Govish/Foxglove-DSP-Amplifier-Hardware/Renderings/Amplifier Rendering 2.PNG

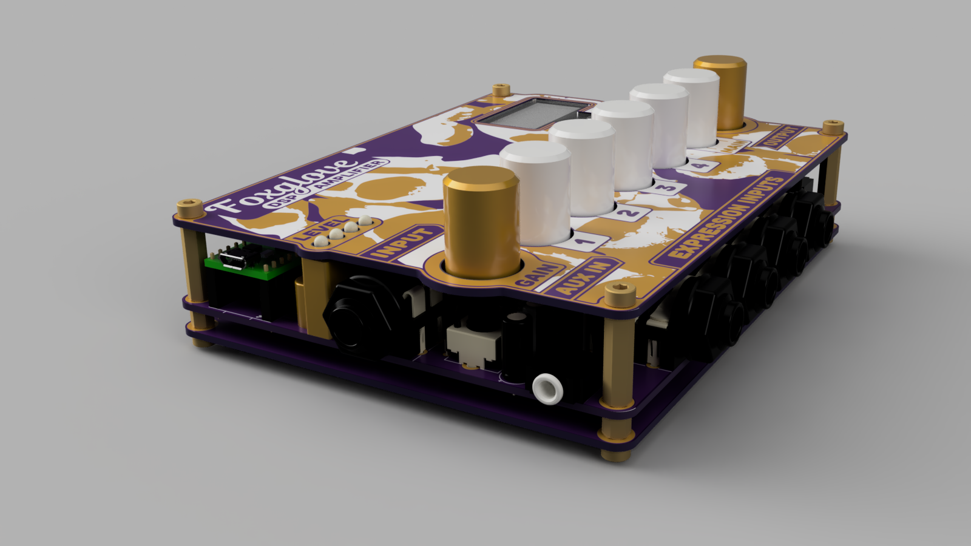
Renderings/Amplifier Rendering 2.PNG
