Govish/Foxglove-DSP-Amplifier-Hardware/Renderings/Amplifier Rendering 4.PNG

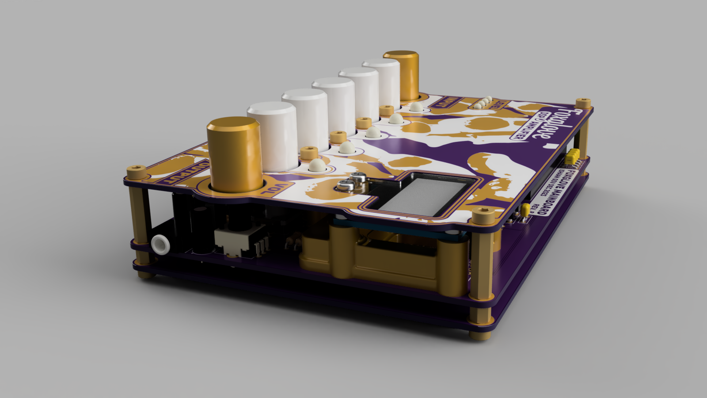
Renderings/Amplifier Rendering 4.PNG
