Govish/Foxglove-DSP-Amplifier-Hardware/README.md

# Foxglove DSP Amplifier
 Design data for a DSP-based guitar effects processor
