Govish/Foxglove-DSP-Amplifier-Hardware/Amplifier ECAD/graphics/Mainboard Label.png

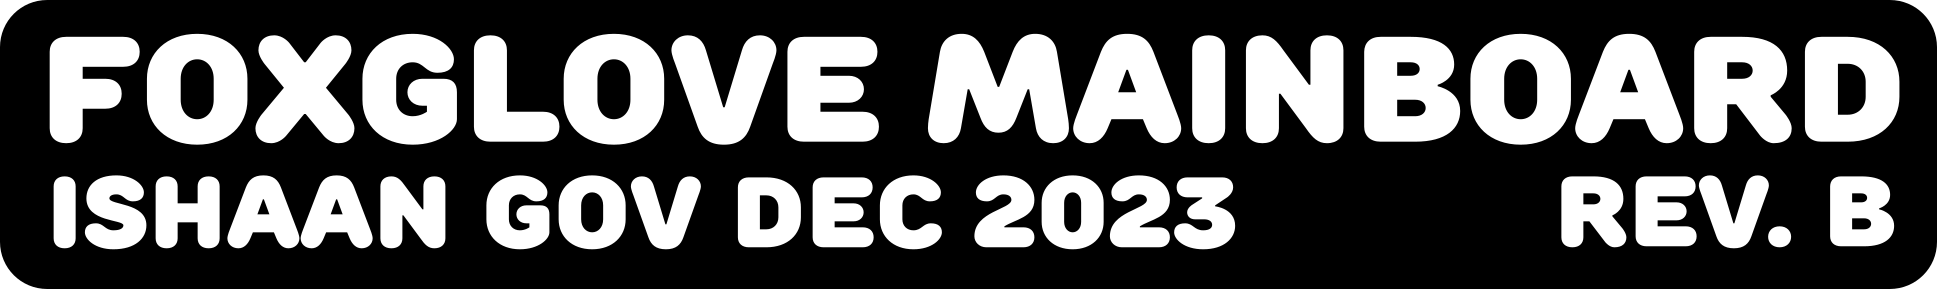
Amplifier ECAD/graphics/Mainboard Label.png
