Govish/Foxglove-DSP-Amplifier-Hardware/Renderings/Amplifier Rendering 1.PNG

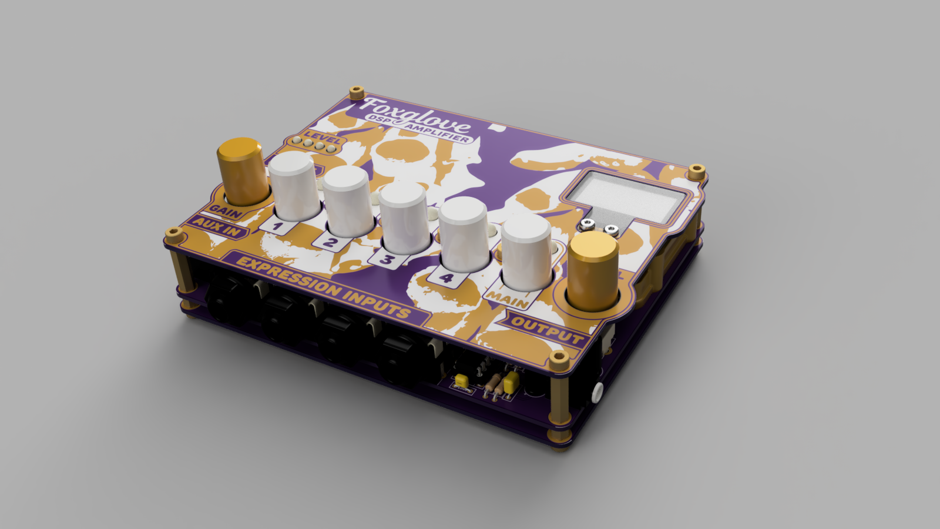
Renderings/Amplifier Rendering 1.PNG
