Govish/Foxglove-DSP-Amplifier-Hardware/Renderings/Amplifier Rendering 3.PNG

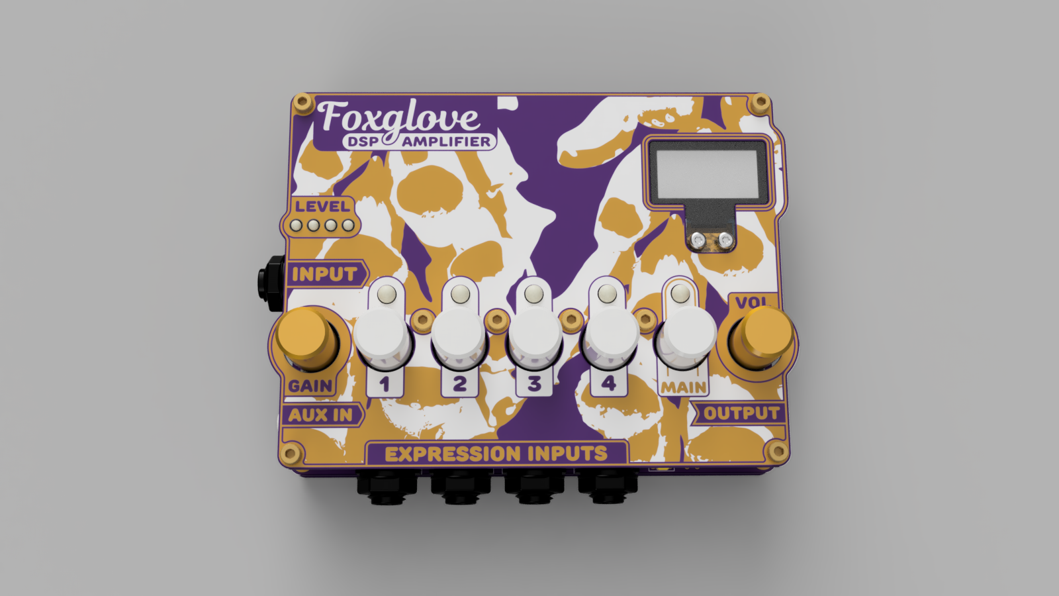
Renderings/Amplifier Rendering 3.PNG
