Govish/Foxglove-DSP-Amplifier-Hardware/Renderings/Amplifier Rendering 5.PNG

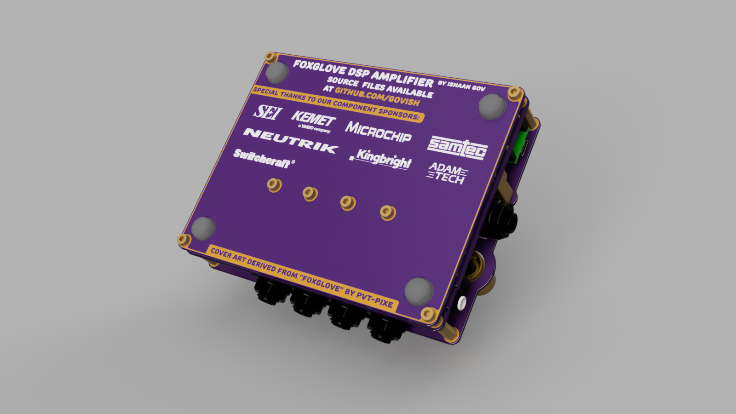
Renderings/Amplifier Rendering 5.PNG
