Govish/Foxglove-DSP-Amplifier-Hardware/Amplifier Rear Panel/Amplifier Rear Panel/Amplifier Rear Panel.step

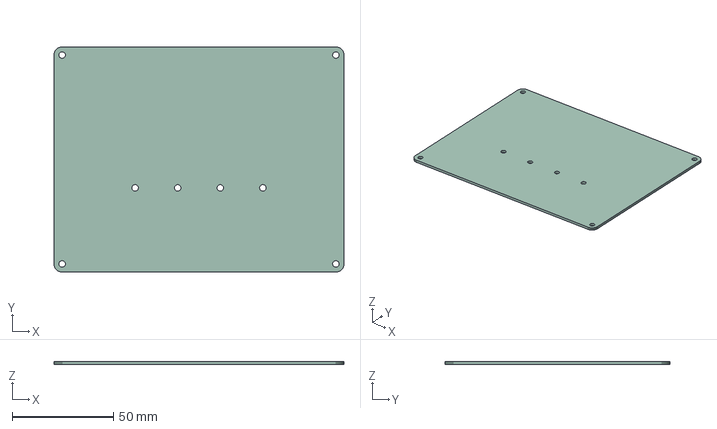
[picture p7: CAD file, 2024-01-23]
Amplifier Rear Panel/Amplifier Rear Panel/Amplifier Rear Panel.step
143.0 x 111.0 x 1.58 mm
