Govish/Foxglove-DSP-Amplifier-Hardware/Amplifier ECAD/Amplifier Hardware RevB.pdf

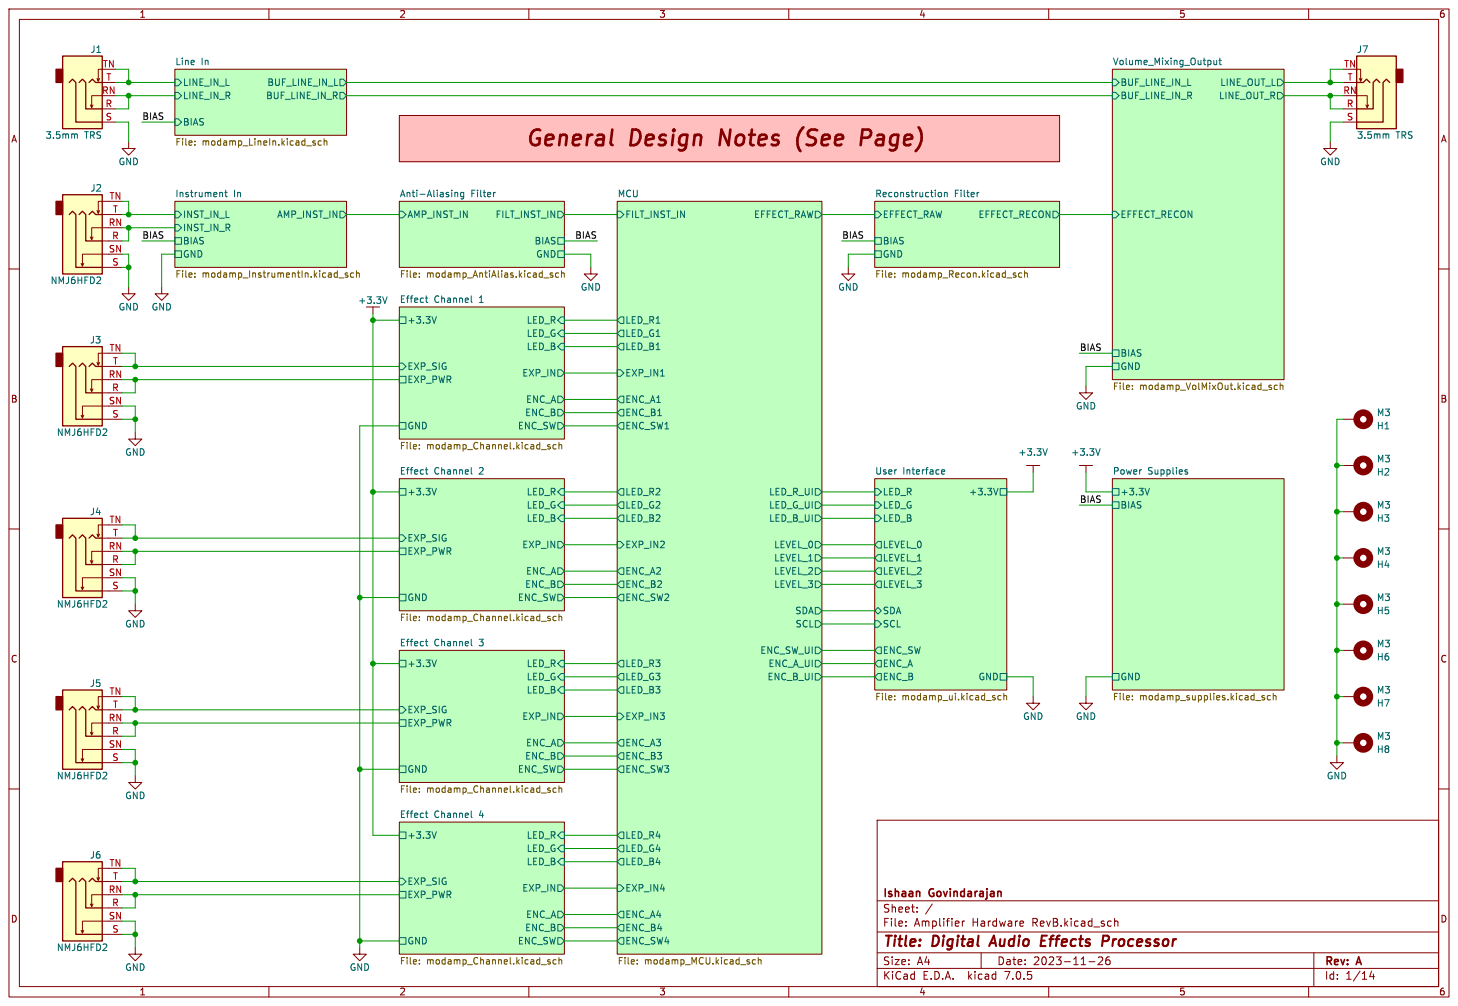
[picture p8: page 1]

INST_IN_R GND
Effect Channel 2 File: modamp_Channel.kicad_sch BIAS

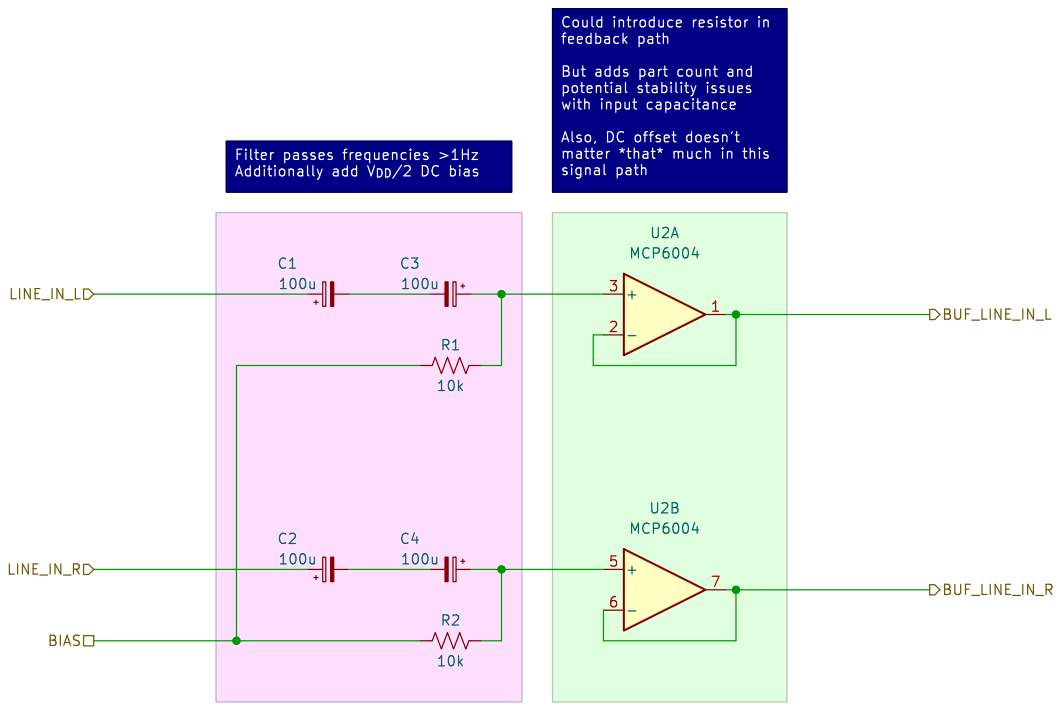
[picture p9: page 2]

feedback path But adds part count and

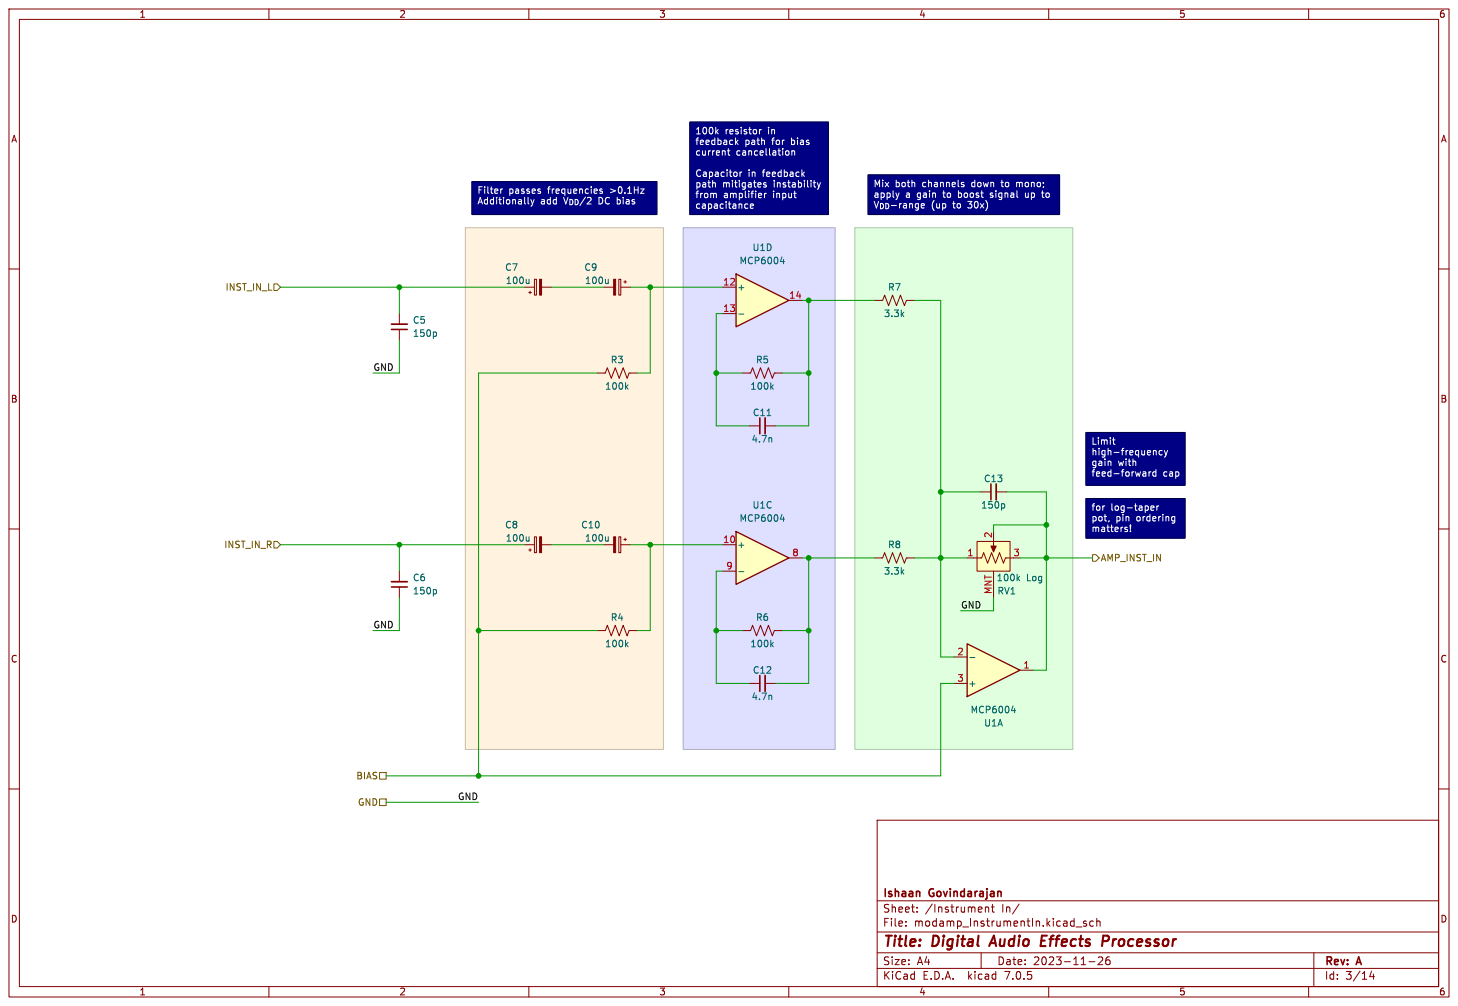
[picture p10: page 3]

for log-taper pot, pin ordering matters! Limit high-frequency

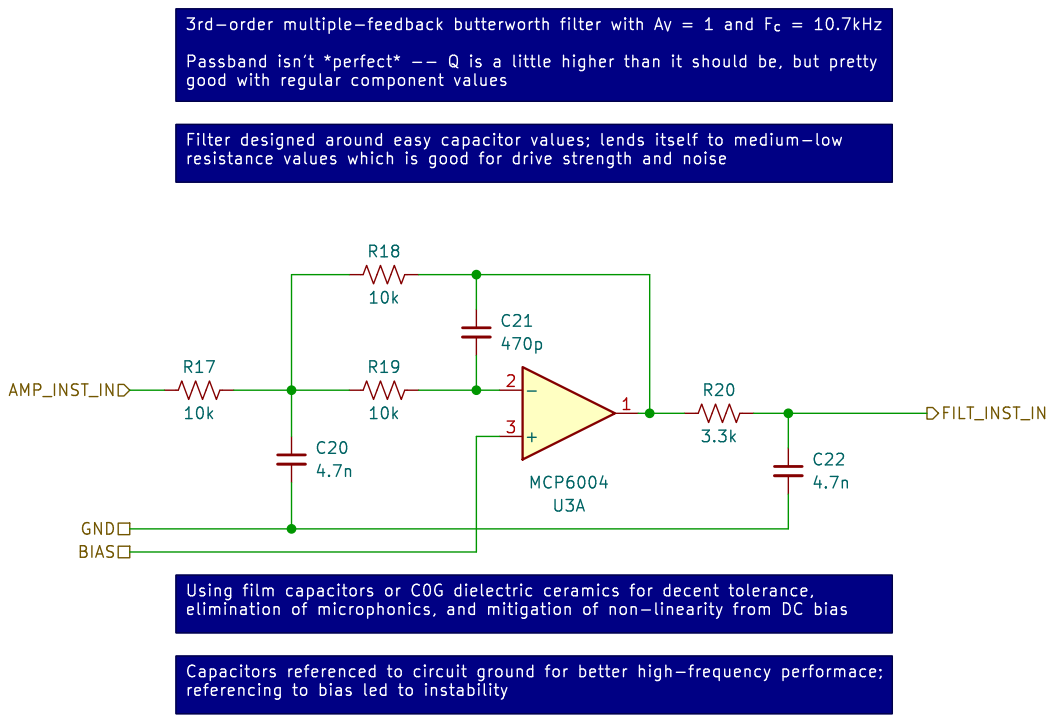
[picture p11: page 4]

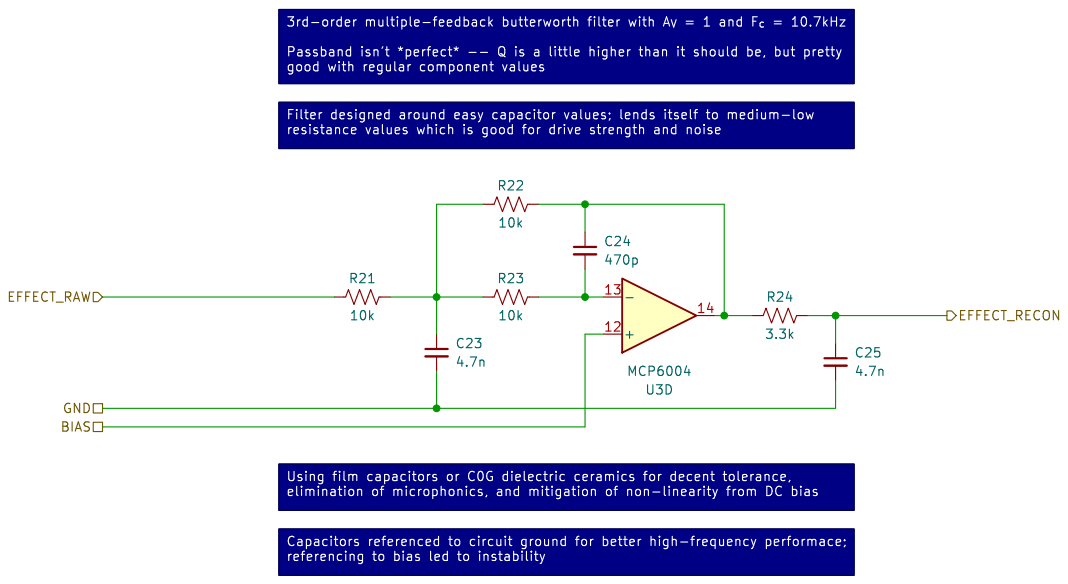
[picture p12: page 5]

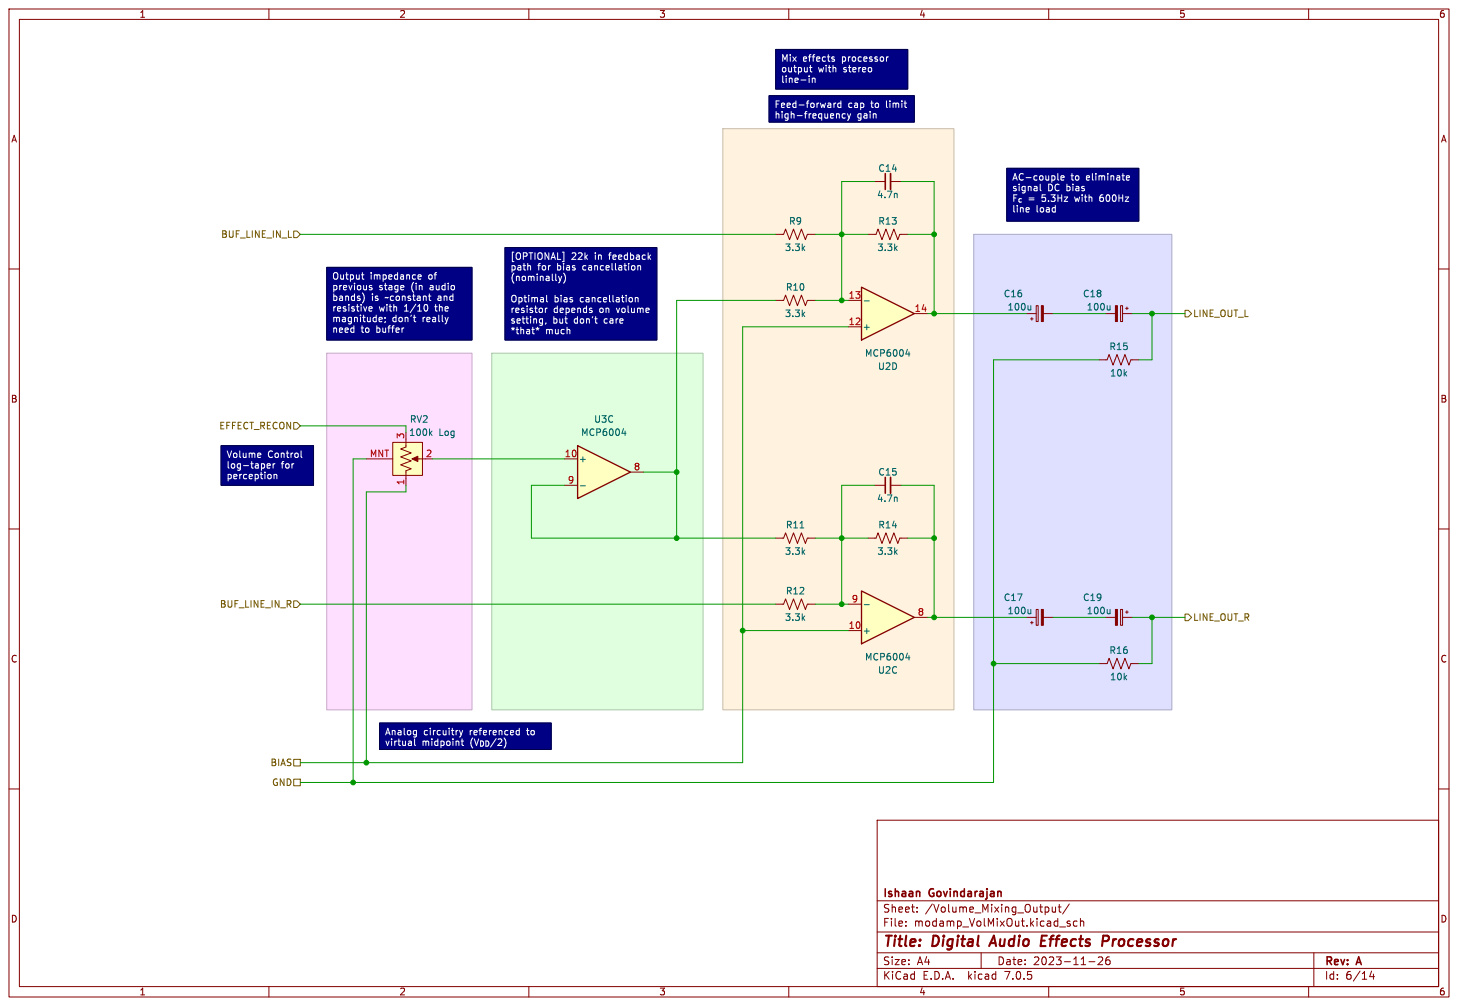
[picture p13: page 6]

signal DC bias F_{c}= 5.3Hz with 600Hz

bands) is ~constant and

Optimal bias cancellation
setting, but don't care

Ishaan Govindarajan
Id: 6/14 Title: Digital Audio Effects Processor File: modamp_VolMixOut.kicad_sch Sheet: /Volume_Mixing_Output/

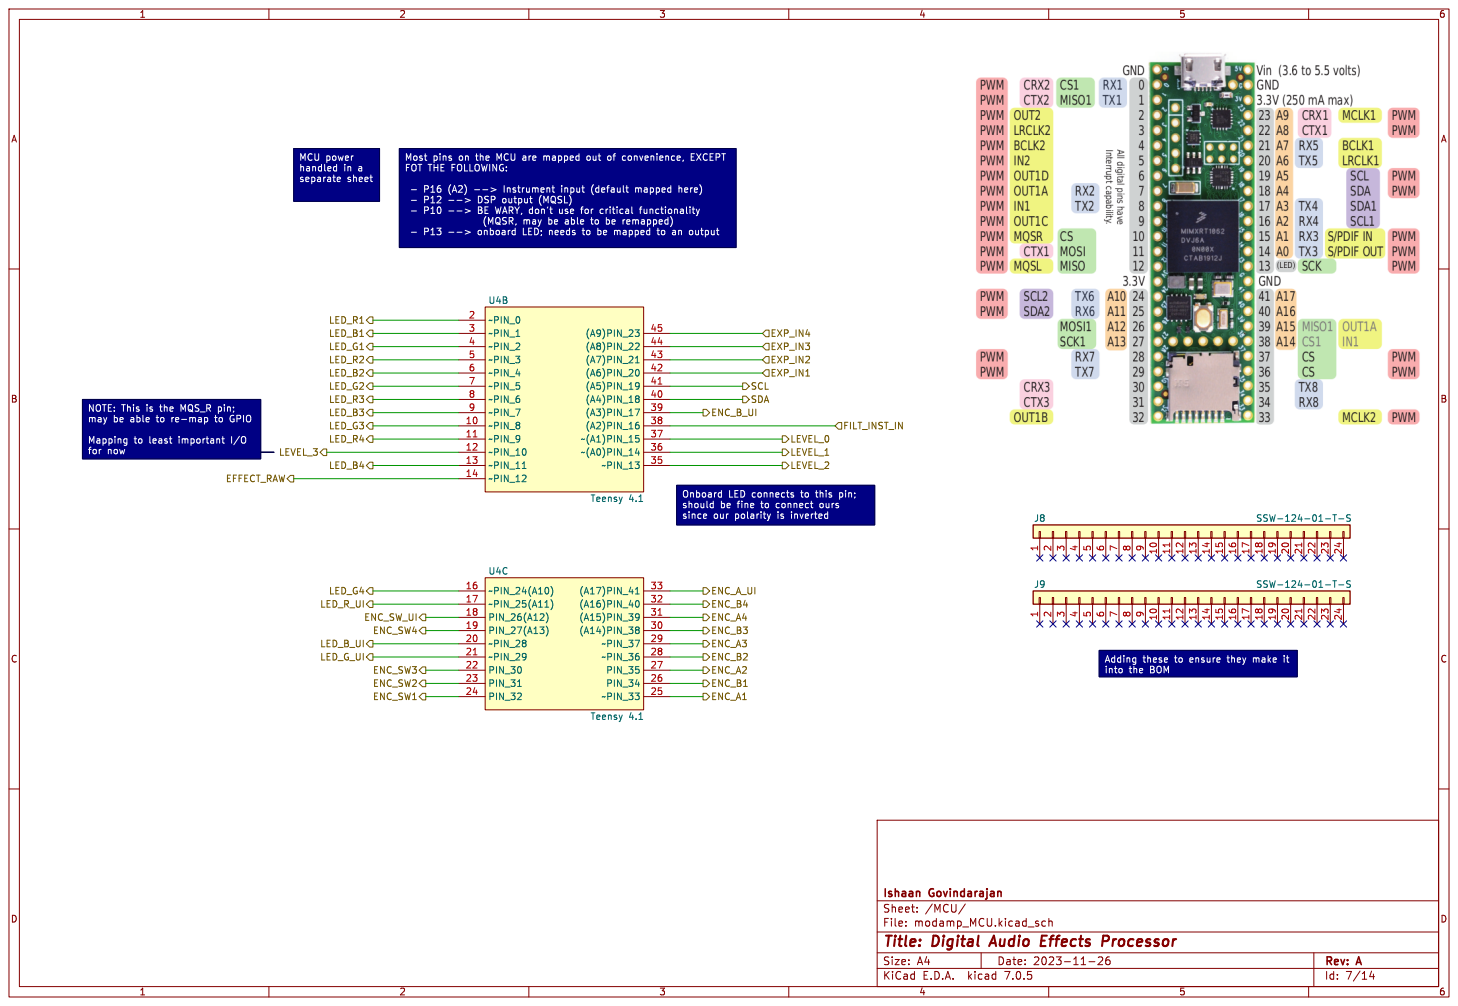
[picture p14: page 7]

MCU power handled in a

Ishaan Govindarajan
Id: 7/14 Title: Digital Audio Effects Processor File: modamp_MCU.kicad_sch Sheet: /MCU/

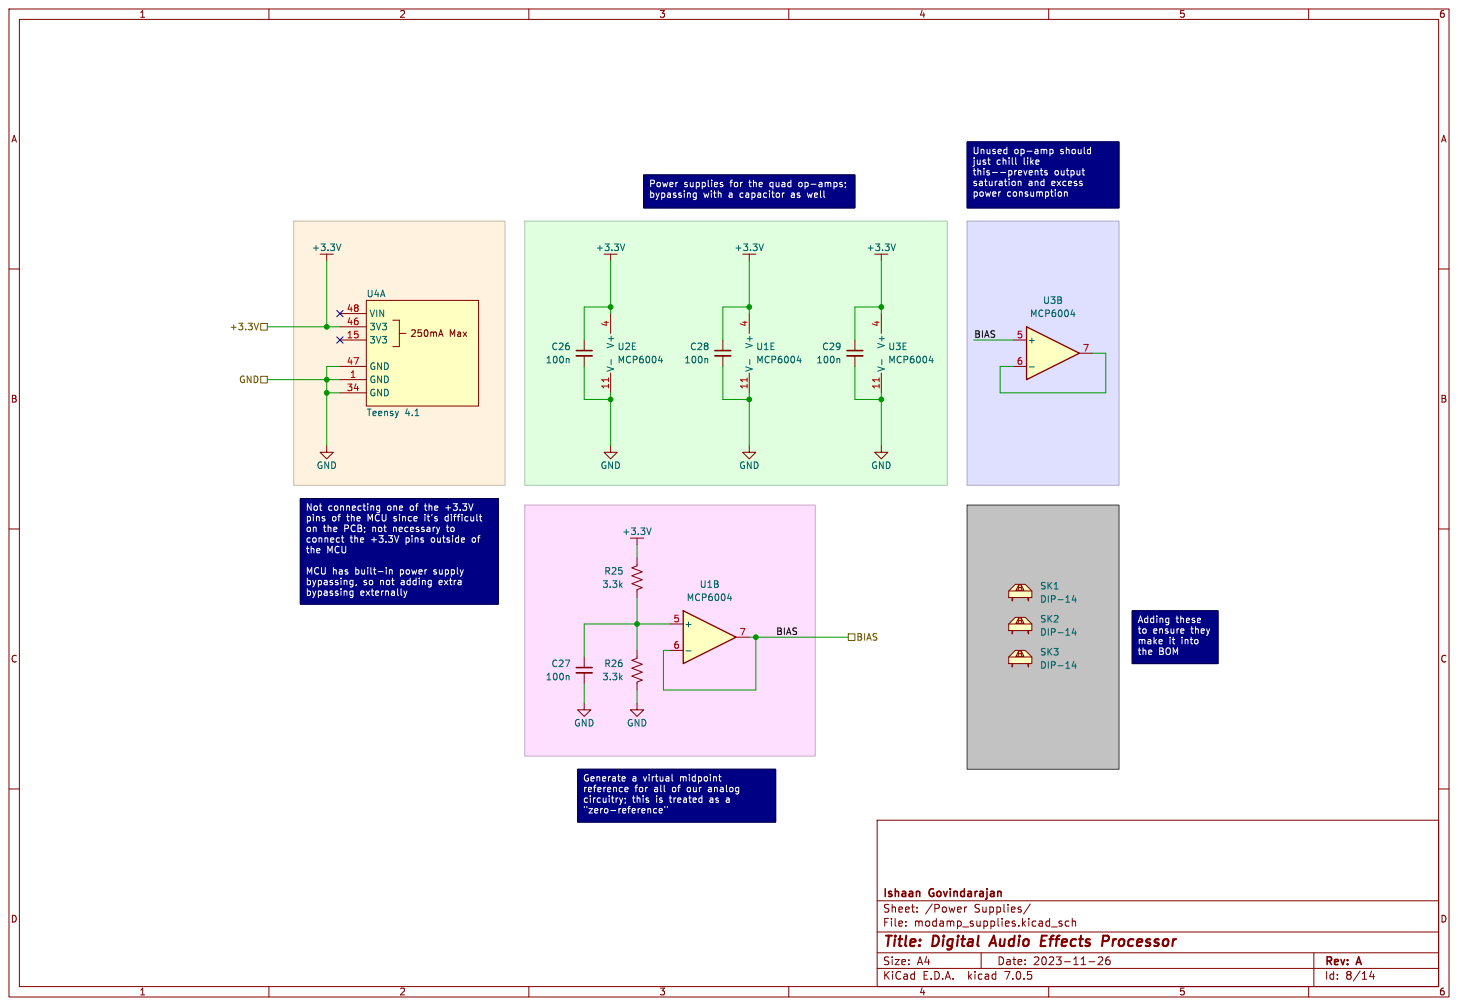
[picture p15: page 8]

pins of the MCU since it's difficult on the PCB; not necessary to

connect the +3.3V pins outside of

Adding these
to ensure they make it into

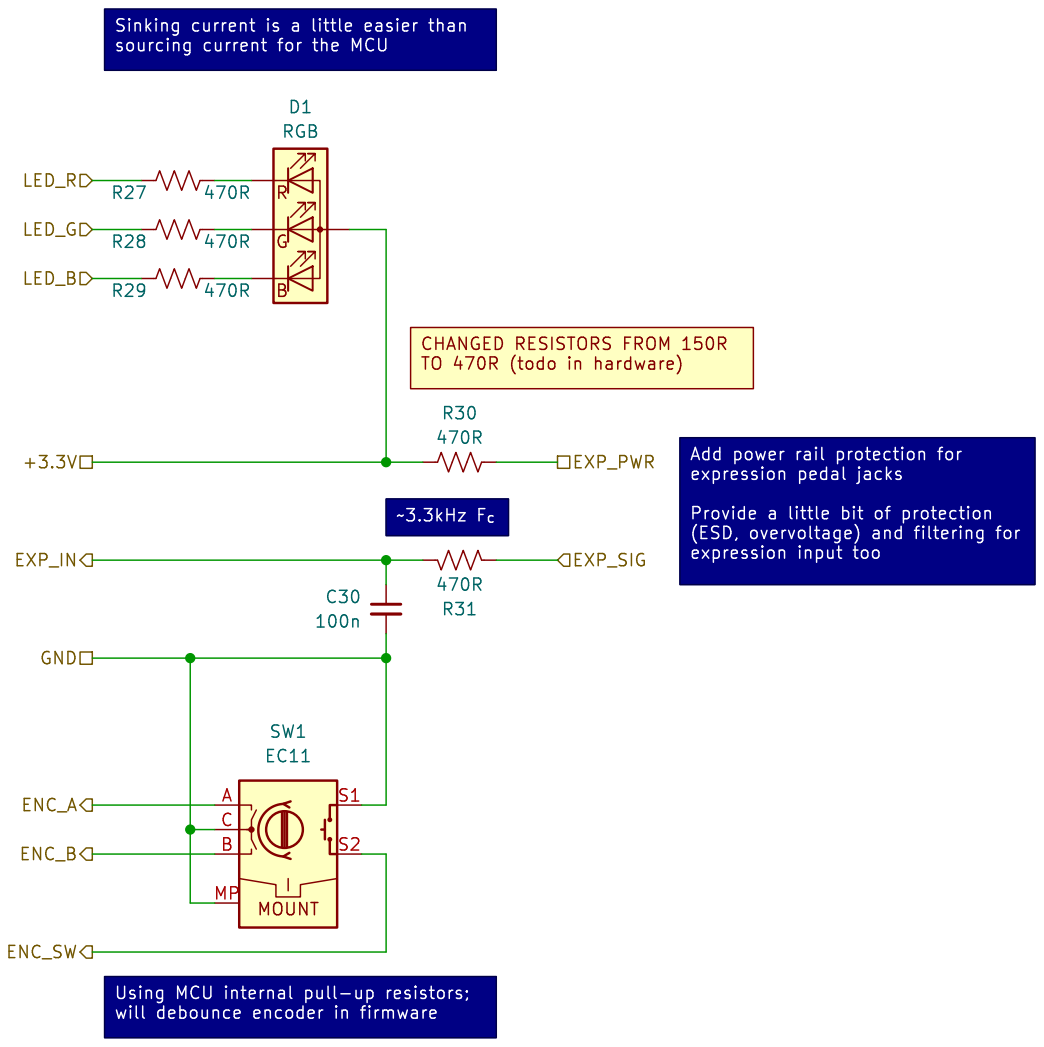
[picture p16: page 9]

Sinking current is a little easier than

TO 470R (todo in hardware)

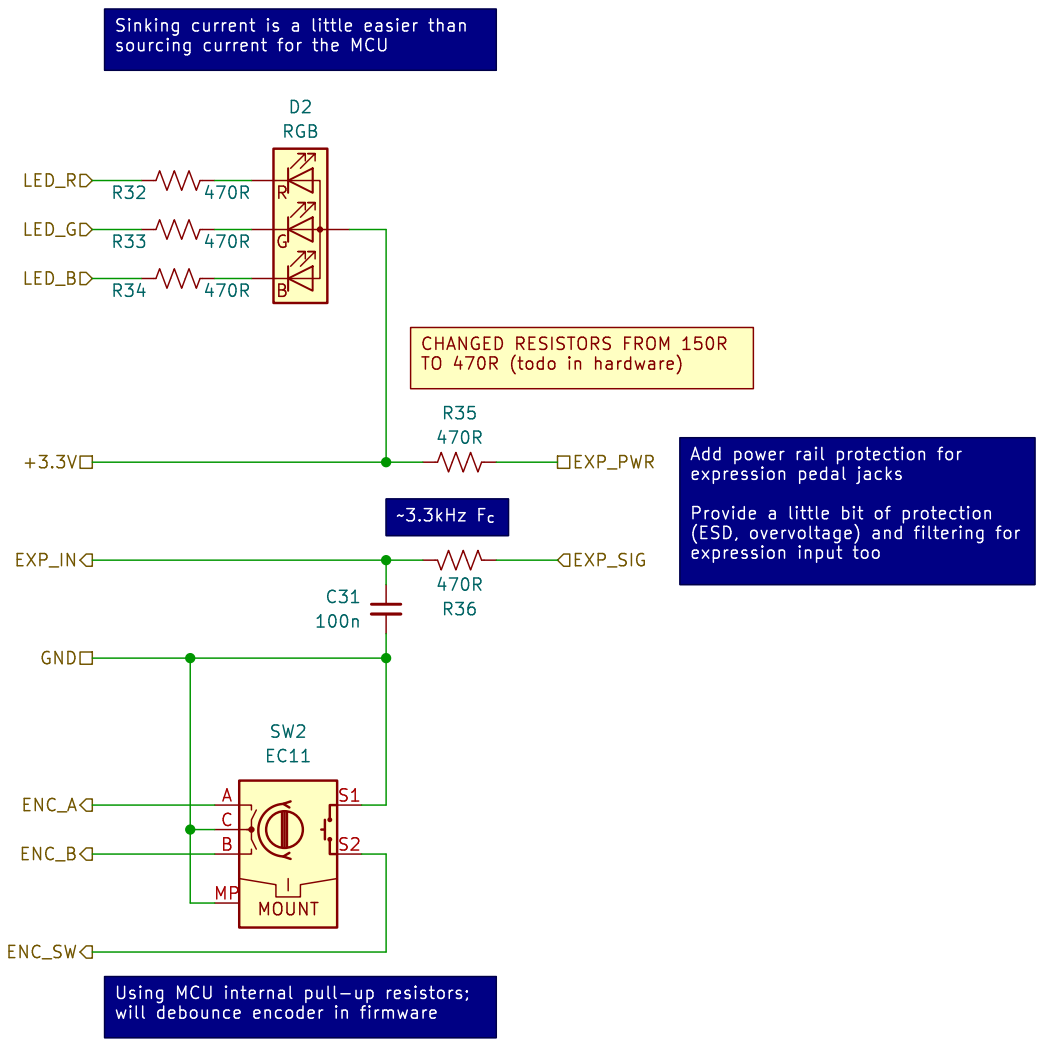
[picture p17: page 10]

Sinking current is a little easier than

TO 470R (todo in hardware)

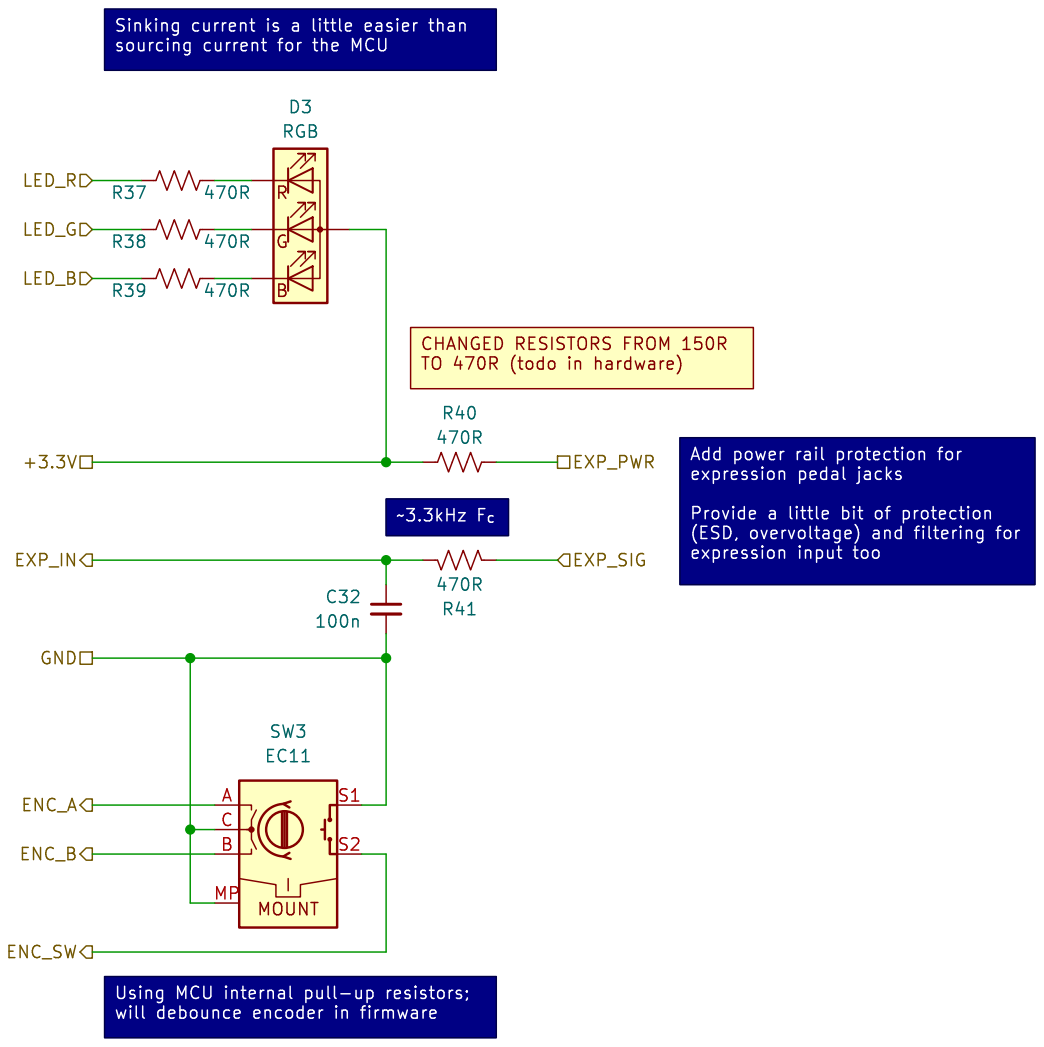
[picture p18: page 11]

Sinking current is a little easier than

TO 470R (todo in hardware)

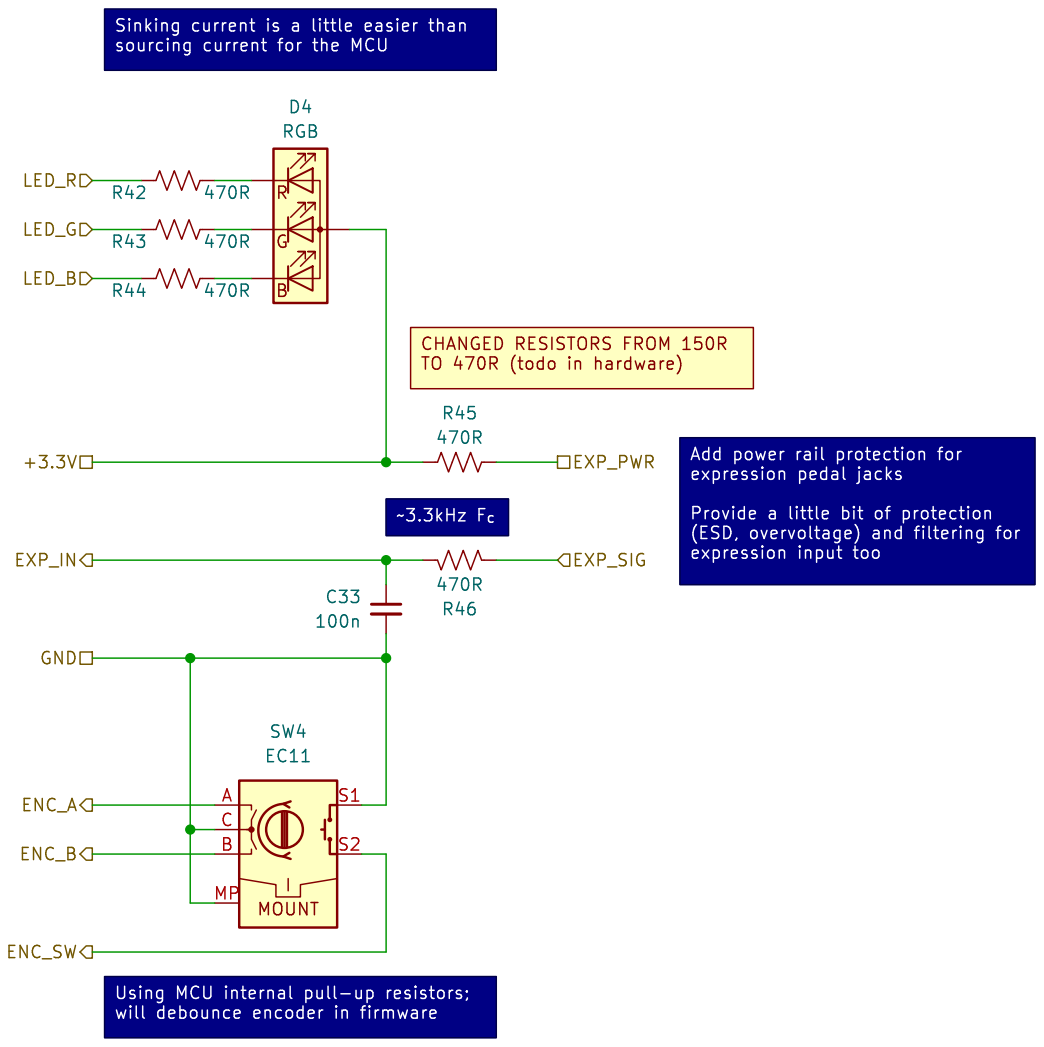
[picture p19: page 12]

Sinking current is a little easier than

TO 470R (todo in hardware)

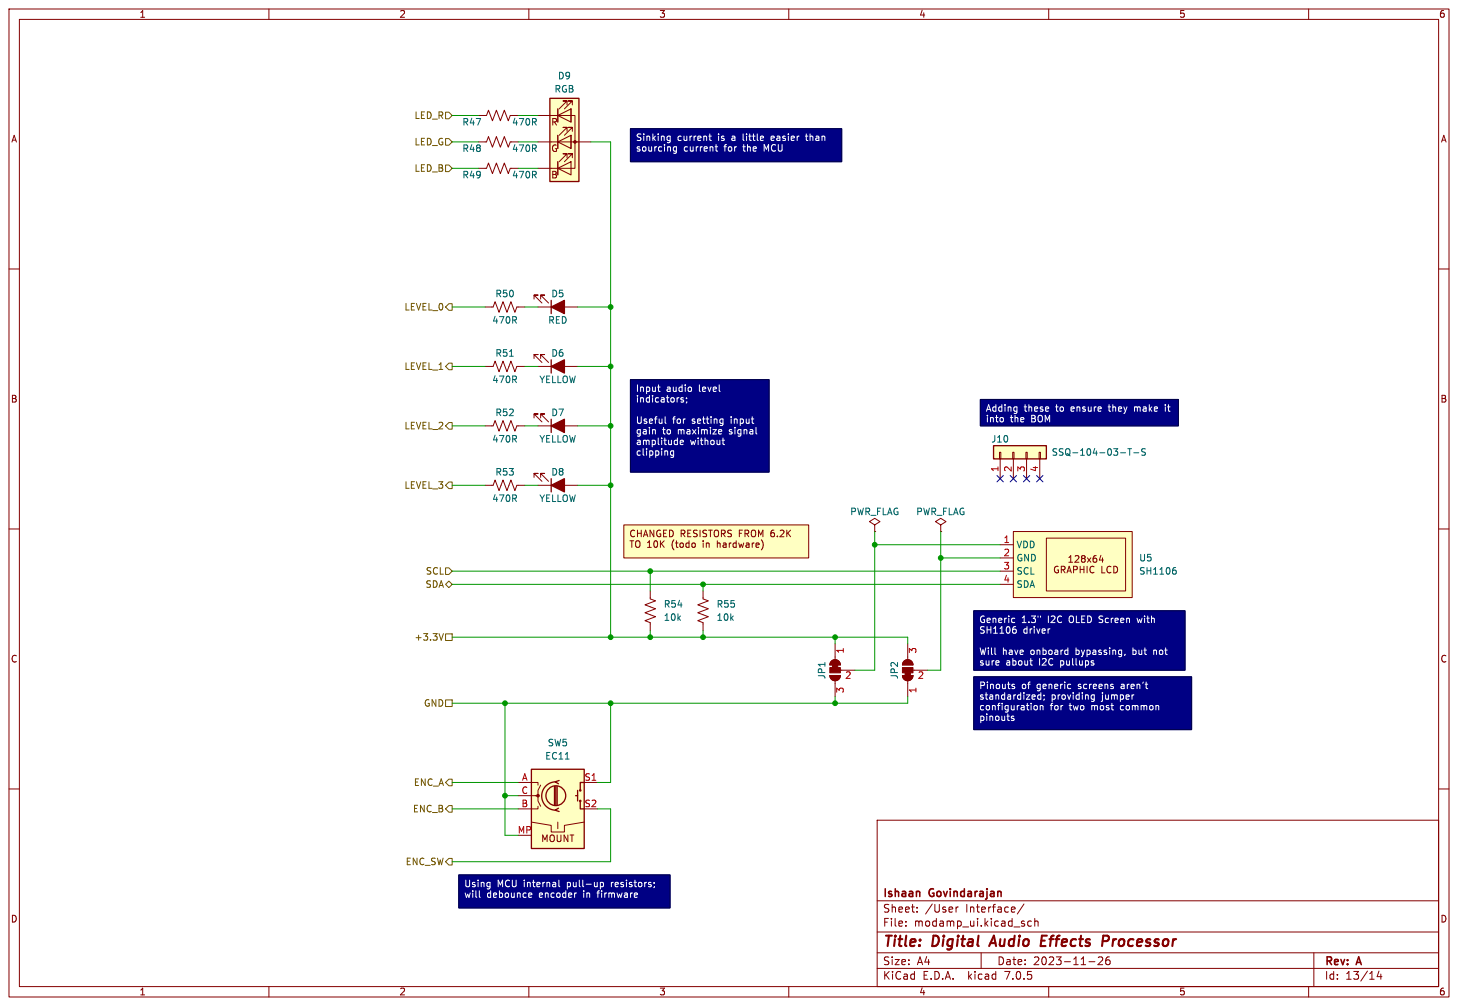
[picture p20: page 13]

Sinking current is a little easier than

Input audio level
indicators; Useful for setting input

Adding these to ensure they make it
into the BOM

CHANGED RESISTORS FROM 6.2K
TO 10K (todo in hardware)

Ishaan Govindarajan
Id: 13/14 Title: Digital Audio Effects Processor File: modamp_ui.kicad_sch Sheet: /User Interface/

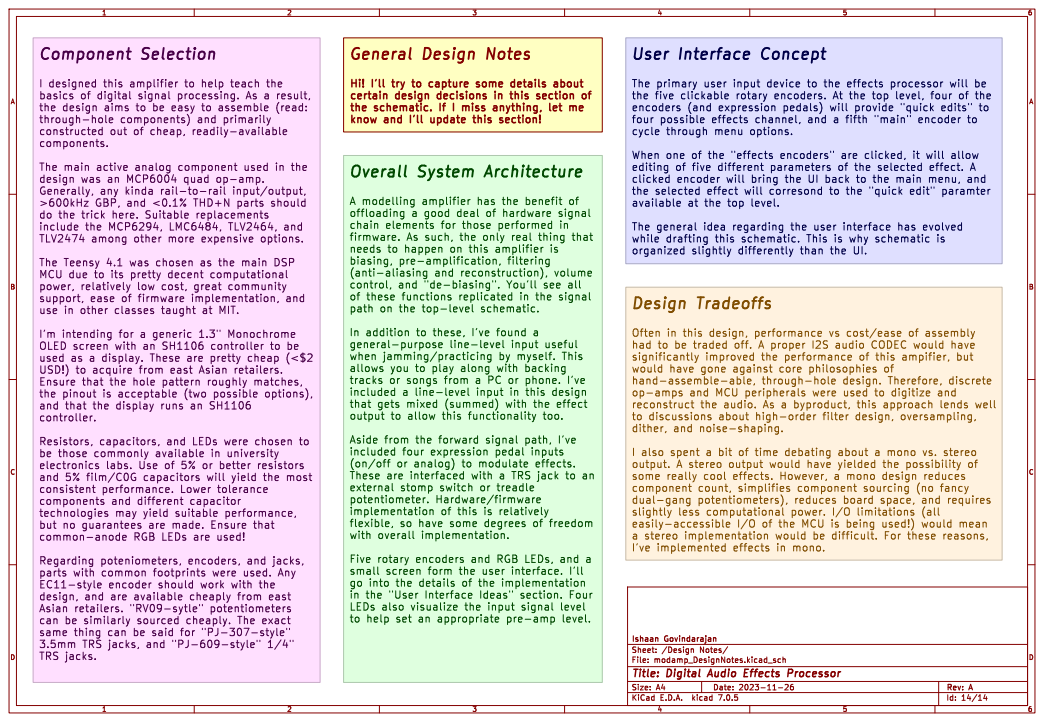
[picture p21: page 14]

the design aims to be easy to assemble (read:
components.

Hi! I'll try to capture some details about
certain design decisions in this section of
the schematic. If I miss anything, let me
know and I'll update this section!

the selected effect will corresond to the "quick edit" paramter

design was an MCP6004 quad op-amp.
do the trick here. Suitable replacements
include the MCP6294, LMC6484, TLV2464, and
TLV2474 among other more expensive options.

firmware. As such, the only real thing that

The Teensy 4.1 was chosen as the main DSP
MCU due to its pretty decent computational
use in other classes taught at MIT.

used as a display. These are pretty cheap (<$2
USD!) to acquire from east Asian retailers.
Ensure that the hole pattern roughly matches,
and that the display runs an SH1106
controller.

In addition to these, I've found a
allows you to play along with backing
tracks or songs from a PC or phone. I've

had to be traded off. A proper I2S audio CODEC would have
dither, and noise-shaping.

Aside from the forward signal path, I've
external stomp switch or treadle
with overall implementation.

I also spent a bit of time debating about a mono vs. stereo

Five rotary encoders and RGB LEDs, and a
go into the details of the implementation
in the "User Interface Ideas" section. Four
LEDs also visualize the input signal level
