Govish/Foxglove-DSP-Amplifier-Hardware/Amplifier Sims/Input Stage.asc

C4: cap; 100n
C5: cap; 100µ
C6: cap; 100µ
C7: cap; 100µ
C8: cap; 100µ
R5: res; 6k2
R6: res; 6k2
R7: res; 3k
R8: res; 100k
R9: res; 100k
R10: res; 100k
R11: res; 100k
R12: res; 3k
R13: res; 3k
R14: res; 60k
R15: res; 10
U2: opamp2; LMC648x
U3: opamp2; LMC648x
U4: opamp2; LMC648x
U5: opamp2; LMC648x
V1: voltage; 3.3
V3: voltage; SINE(0 0.065 800)
Named nets: 0, VDD, VREF
.lib LMC648x.subckt
.tran 0.1
