Govish/Foxglove-DSP-Amplifier-Hardware/Amplifier ECAD/Amplifier Hardware RevB.kicad_pcb

## KiCad design Amplifier ECAD/Amplifier Hardware RevB.kicad_pcb (2024-01-23)

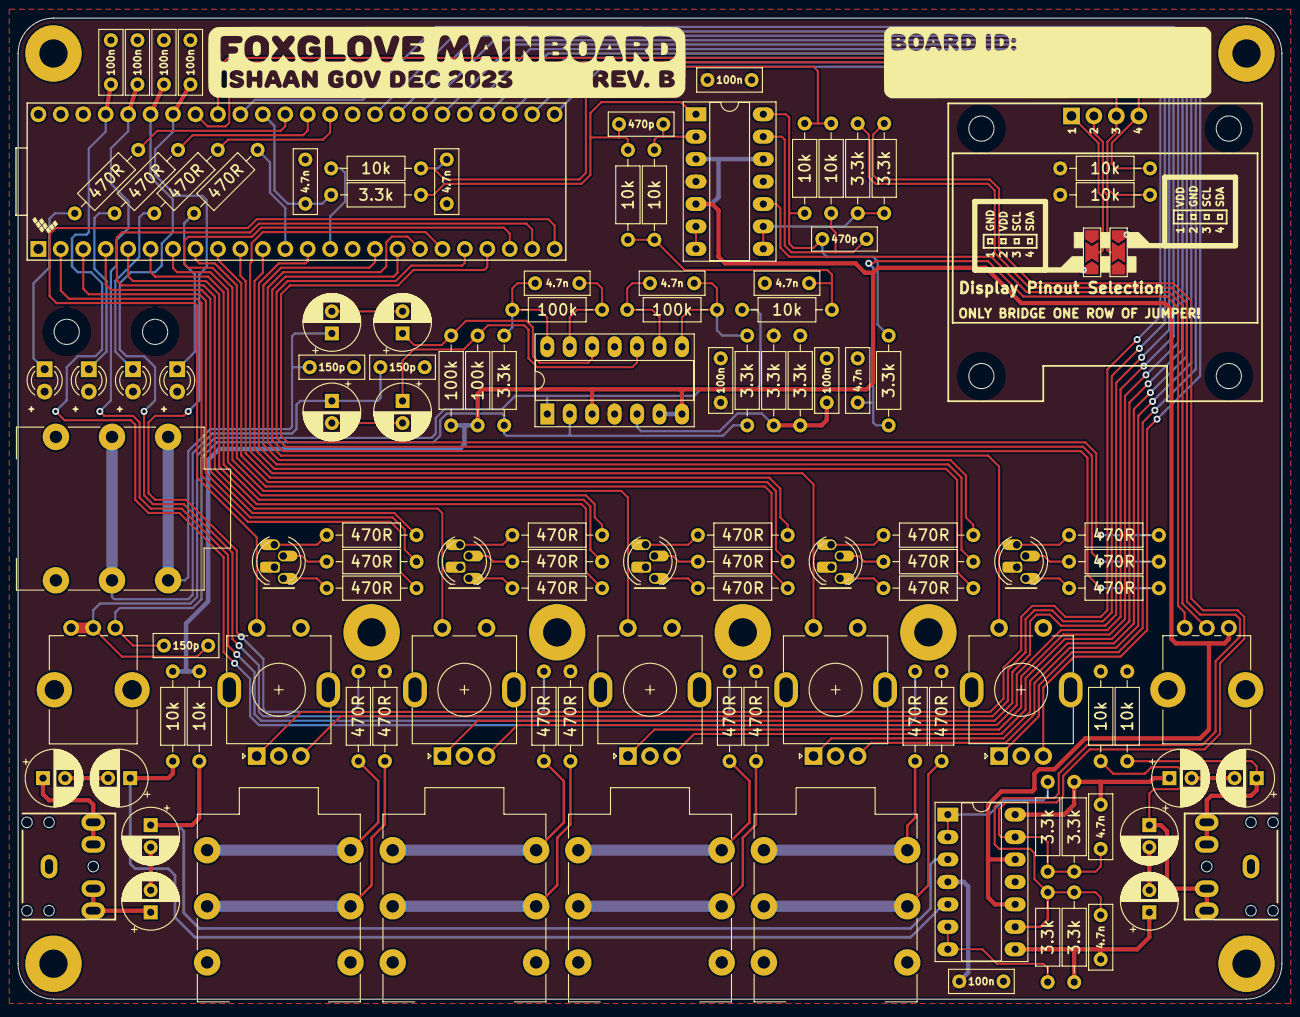
[picture p22: board Amplifier Hardware RevB.kicad_pcb from above]

Board: 2 copper layers, 143.0 x 111.0 mm, 132 parts (0 on the bottom side), 113 nets.

Parts:
C1, C2, C3, C4, C7, C8, C9, C10, C16, C17, C18, C19: 100u; CP_KEMET_ESY
C5, C6, C13: 150p; C_KEMET_C317
C11, C12, C14, C15, C20, C22, C23, C25: 4.7n; C_KEMET_C322
C21, C24: 470p; C_KEMET_C317
C26, C27, C28, C29, C30, C31, C32, C33: 100n; C_KEMET_C317
D1, D2, D3, D4, D9: RGB; LED_D5.0mm-4_RGB
D5: RED; LED_D3.0mm_Clear
D6, D7, D8: YELLOW; LED_D3.0mm_Clear
H1, H2, H3, H4, H5, H6, H7, H8: M3; MountingHole_3.2mm_M3_Pad
H9, H10, H11, H12, H13, H14: M2.6; MountingHole_2.9mm_5.5mm_Ring
J1, J7: 3.5mm TRS; PJ-307
J2, J3, J4, J5, J6: NMJ6HFD2; Jack_6.35mm_Neutrik_NMJ6HFD2_Horizontal
JP1, JP2: SolderJumper_3_Bridged12; SolderJumper-3_P2.0mm_Open_TrianglePad1.0x1.5mm
R1, R2, R15, R16, R17, R18, R19, R21, R22, R23, R54, R55: 10k; R_Axial_DIN0207_L6.3mm_D2.5mm_P10.16mm_Horizontal
R3, R4, R5, R6: 100k; R_Axial_DIN0207_L6.3mm_D2.5mm_P10.16mm_Horizontal
R7, R8, R9, R10, R11, R12, R13, R14, R20, R24, R25, R26: 3.3k; R_Axial_DIN0207_L6.3mm_D2.5mm_P10.16mm_Horizontal
R27, R28, R29, R30, R31, R32, R33, R34, R35, R36, R37, R38, R39, R40, R41, R42, R43, R44, R45, R46, R47, R48, R49, R50, R51, R52, R53: 470R; R_Axial_DIN0207_L6.3mm_D2.5mm_P10.16mm_Horizontal
RV1, RV2: 100k Log; Potentiometer_Bourns_PTV09A-1_Single_Vertical
SW1, SW2, SW3, SW4, SW5: EC11; RotaryEncoder_Alps_EC11E-Switch_Vertical_H20mm
U1, U2, U3: MCP6004; DIP-14_W7.62mm_Socket_LongPads_IC
U4: Teensy 4.1; Teensy_4_1_Basic_Socket
U5: SH1106; SH1106_LCD_MODULE

Connections:
+3.3V: C26.1, C28.1, C29.1, D1.2 (A), D2.2 (A), D3.2 (A), D4.2 (A), D5.2 (A), D6.2 (A), D7.2 (A), D8.2 (A), D9.2 (A), JP1.1 (A), JP2.3 (B), R25.2, R30.1, R35.1, R40.1, R45.1, R54.1, R55.1, U1.4 (V+), U2.4 (V+), U3.4 (V+), U4.46 (3V3)
/Anti-Aliasing Filter/AMP_INST_IN: C13.2, R17.1, RV1.2, RV1.3, U1.1
/Anti-Aliasing Filter/FILT_INST_IN: C22.1, R20.2, U4.38 ((A2)PIN_16)
/BIAS: R1.1, R2.1, R3.1, R4.1, RV2.1, U1.3 (+), U1.6 (-), U1.7, U2.10 (+), U2.12 (+), U3.3 (+), U3.5 (+), U3.12 (+)
/Effect Channel 1/ENC_A: SW1.A, U4.25 (~PIN_33)
/Effect Channel 1/ENC_B: SW1.B, U4.26 (PIN_34)
/Effect Channel 1/ENC_SW: SW1.S2, U4.24 (PIN_32)
/Effect Channel 1/EXP_IN: C30.1, R31.1, U4.42 ((A6)PIN_20)
/Effect Channel 1/EXP_PWR: J3.R, J3.RN, R30.2
/Effect Channel 1/EXP_SIG: J3.T, J3.TN, R31.2
/Effect Channel 1/LED_B: R29.1, U4.3 (~PIN_1)
/Effect Channel 1/LED_G: R28.1, U4.4 (~PIN_2)
/Effect Channel 1/LED_R: R27.1, U4.2 (~PIN_0)
/Effect Channel 2/ENC_A: SW2.A, U4.27 (PIN_35)
/Effect Channel 2/ENC_B: SW2.B, U4.28 (~PIN_36)
/Effect Channel 2/ENC_SW: SW2.S2, U4.23 (PIN_31)
/Effect Channel 2/EXP_IN: C31.1, R36.1, U4.43 ((A7)PIN_21)
/Effect Channel 2/EXP_PWR: J4.R, J4.RN, R35.2
/Effect Channel 2/EXP_SIG: J4.T, J4.TN, R36.2
/Effect Channel 2/LED_B: R34.1, U4.6 (~PIN_4)
/Effect Channel 2/LED_G: R33.1, U4.7 (~PIN_5)
/Effect Channel 2/LED_R: R32.1, U4.5 (~PIN_3)
/Effect Channel 3/ENC_A: SW3.A, U4.29 (~PIN_37)
/Effect Channel 3/ENC_B: SW3.B, U4.30 ((A14)PIN_38)
/Effect Channel 3/ENC_SW: SW3.S2, U4.22 (PIN_30)
/Effect Channel 3/EXP_IN: C32.1, R41.1, U4.44 ((A8)PIN_22)
/Effect Channel 3/EXP_PWR: J5.R, J5.RN, R40.2
/Effect Channel 3/EXP_SIG: J5.T, J5.TN, R41.2
/Effect Channel 3/LED_B: R39.1, U4.9 (~PIN_7)
/Effect Channel 3/LED_G: R38.1, U4.10 (~PIN_8)
/Effect Channel 3/LED_R: R37.1, U4.8 (~PIN_6)
/Effect Channel 4/ENC_A: SW4.A, U4.31 ((A15)PIN_39)
/Effect Channel 4/ENC_B: SW4.B, U4.32 ((A16)PIN_40)
/Effect Channel 4/ENC_SW: SW4.S2, U4.19 (PIN_27(A13))
/Effect Channel 4/EXP_IN: C33.1, R46.1, U4.45 ((A9)PIN_23)
/Effect Channel 4/EXP_PWR: J6.R, J6.RN, R45.2
/Effect Channel 4/EXP_SIG: J6.T, J6.TN, R46.2
/Effect Channel 4/LED_B: R44.1, U4.13 (~PIN_11)
/Effect Channel 4/LED_G: R43.1, U4.16 (~PIN_24(A10))
/Effect Channel 4/LED_R: R42.1, U4.11 (~PIN_9)
/Instrument In/INST_IN_L: C5.2, C7.1, J2.T, J2.TN
/Instrument In/INST_IN_R: C6.2, C8.1, J2.R, J2.RN
/Line In/BUF_LINE_IN_L: R9.1, U2.1, U2.2 (-)
/Line In/BUF_LINE_IN_R: R12.1, U2.6 (-), U2.7
/Line In/LINE_IN_L: C1.1, J1.T, J1.TN
/Line In/LINE_IN_R: C2.1, J1.R, J1.RN
/MCU/EFFECT_RAW: R21.1, U4.14 (~PIN_12)
/MCU/ENC_A_UI: SW5.A, U4.33 ((A17)PIN_41)
/MCU/ENC_B_UI: SW5.B, U4.39 ((A3)PIN_17)
/MCU/ENC_SW_UI: SW5.S2, U4.18 (PIN_26(A12))
/MCU/LED_B_UI: R49.1, U4.20 (~PIN_28)
/MCU/LED_G_UI: R48.1, U4.21 (~PIN_29)
/MCU/LED_R_UI: R47.1, U4.17 (~PIN_25(A11))
/MCU/LEVEL_0: R50.1, U4.37 (~(A1)PIN_15)
/MCU/LEVEL_1: R51.1, U4.36 (~(A0)PIN_14)
/MCU/LEVEL_2: R52.1, U4.35 (~PIN_13)
/MCU/LEVEL_3: R53.1, U4.12 (~PIN_10)
/MCU/SCL: R54.2, U4.41 ((A5)PIN_19), U5.3 (SCL)
/MCU/SDA: R55.2, U4.40 ((A4)PIN_18), U5.4 (SDA)
/Reconstruction Filter/EFFECT_RECON: C25.1, R24.2, RV2.3
/Volume_Mixing_Output/LINE_OUT_L: C18.1, J7.T, J7.TN, R15.2
/Volume_Mixing_Output/LINE_OUT_R: C19.1, J7.R, J7.RN, R16.2
GND: C5.1, C6.1, C20.2, C22.2, C23.2, C25.2, C26.2, C27.2, C28.2, C29.2, C30.2, C31.2, C32.2, C33.2, H1.1, H2.1, H3.1, H4.1, H5.1, H6.1, H7.1, H8.1, J1.S, J2.S, J2.SN, J3.S, J3.SN, J4.S, J4.SN, J5.S, J5.SN, J6.S, J6.SN, J7.S, JP1.3 (B), JP2.1 (A), R15.1, R16.1, R26.1, RV1.MNT, RV2.MNT, SW1.C, SW1.MP, SW1.S1, SW2.C, SW2.MP, SW2.S1, SW3.C, SW3.MP, SW3.S1, SW4.C, SW4.MP, SW4.S1, SW5.C, SW5.MP, SW5.S1, U1.11 (V-), U2.11 (V-), U3.11 (V-), U4.1 (GND), U4.34 (GND), U4.47 (GND)
unnamed: C1.2, C3.2
unnamed: C2.2, C4.2
unnamed: C7.2, C9.2
unnamed: C8.2, C10.2
unnamed: C11.2, R5.2, R7.1, U1.14
unnamed: C12.2, R6.2, R8.1, U1.8
unnamed: C14.2, C16.1, R13.2, U2.14
unnamed: C15.2, C17.1, R14.2, U2.8
unnamed: C16.2, C18.2
unnamed: C17.2, C19.2
unnamed: C20.1, R17.2, R18.1, R19.1
unnamed: C21.1, R18.2, R20.1, U3.1
unnamed: C23.1, R21.2, R22.1, R23.1
unnamed: C24.1, R22.2, R24.1, U3.14
unnamed: D1.3 (BK), R29.2
unnamed: D1.4 (GK), R28.2
unnamed: D1.1 (RK), R27.2
unnamed: D2.3 (BK), R34.2
unnamed: D2.4 (GK), R33.2
unnamed: D2.1 (RK), R32.2
unnamed: D3.3 (BK), R39.2
unnamed: D3.4 (GK), R38.2
unnamed: D3.1 (RK), R37.2
unnamed: D4.3 (BK), R44.2
unnamed: D4.4 (GK), R43.2
unnamed: D4.1 (RK), R42.2
unnamed: D5.1 (K), R50.2
unnamed: D6.1 (K), R51.2
unnamed: D7.1 (K), R52.2
unnamed: D8.1 (K), R53.2
unnamed: D9.3 (BK), R49.2
unnamed: D9.4 (GK), R48.2
unnamed: D9.1 (RK), R47.2
unnamed: JP1.2 (C), U5.1 (VDD)
unnamed: JP2.2 (C), U5.2 (GND)
unnamed: C13.1, R7.2, R8.2, RV1.1, U1.2 (-)
unnamed: C27.1, R25.1, R26.2, U1.5 (+)
unnamed: C10.1, R4.2, U1.10 (+)
unnamed: C12.1, R6.1, U1.9 (-)
unnamed: C9.1, R3.2, U1.12 (+)
unnamed: C11.1, R5.1, U1.13 (-)
unnamed: C3.1, R1.2, U2.3 (+)
unnamed: C4.1, R2.2, U2.5 (+)
unnamed: C15.1, R11.2, R12.2, R14.1, U2.9 (-)
unnamed: C14.1, R9.2, R10.2, R13.1, U2.13 (-)
unnamed: C21.2, R19.2, U3.2 (-)
unnamed: U3.6 (-), U3.7
unnamed: RV2.2, U3.10 (+)
unnamed: R10.1, R11.1, U3.8, U3.9 (-)
unnamed: C24.2, R23.2, U3.13 (-)
