Govish/Foxglove-DSP-Amplifier-Hardware/(commit log)

2023-11-26 First commit! Publishing first revision of the design
    [Amplifier Hardware R1.kicad_pcb, Amplifier Hardware R1.kicad_sch, modamp_AntiAlias.kicad_sch, modamp_Channel.kicad_sch, modamp_DesignNotes.kicad_sch, modamp_InstrumentIn.kicad_sch, modamp_LineIn.kicad_sch, modamp_MCU.kicad_sch]
2023-12-15 Pushing some updates for the second revision of the board
    [Amplifier Hardware R1 PCB.0002.ipt, Amplifier Hardware R1 PCB.ipt, Amplifier Hardware R1.kicad_pcb, Amplifier Hardware R1.kicad_sch, COMPOUND.ipt, COMPOUND_1.ipt, COMPOUND_2.ipt, COMPOUND_3.ipt]
2023-12-15 Solid polygon connections for holes
    [Amplifier Hardware R1.kicad_pcb, Amplifier Hardware R1.kicad_sch]
2023-12-15 File renaming; updating supplier references
    [Amplifier Hardware RevB.kicad_pcb, Amplifier Hardware RevB.kicad_sch, modamp_AntiAlias.kicad_sch, modamp_Channel.kicad_sch, modamp_DesignNotes.kicad_sch, modamp_InstrumentIn.kicad_sch, modamp_LineIn.kicad_sch, modamp_MCU.kicad_sch]
2023-12-19 Test firmware for Foxglove
    [bot_cover_template.0001.ipt, bot_cover_template.0002.ipt, bot_cover_template.ipt, mainboard.0001.iam, mainboard.0002.iam, mainboard.iam]
2023-12-25 Front and rear panel work; renderings on Fusion360
    [Amplifier Front Panel.kicad_pcb, Amplifier Front Panel.kicad_sch, Amplifier Hardware R1 PCB.0002.ipt, Amplifier Hardware R1 PCB.ipt, Amplifier Hardware RevB.kicad_pcb, Amplifier Hardware RevB.kicad_sch, Amplifier Rear Panel.kicad_pcb, Amplifier Rear Panel.kicad_sch]
2023-12-28 Firmware work--RGB LEDs, Encoders, Scheduler
2024-01-17 IIR Lowpass, Minor effect encoder initialization bugfix
